klebol/Klebot_PCB/bom.xlsx

Sheet: Arkusz1
Nazwa | Obudowa | Ilość | URL | Stan
KONDENSATORY
1uF 6V | 0603 | 3 | https://www.tme.eu/pl/details/cl10b105ka8nnnc/kondensatory-mlcc-smd/samsung/ | X
10uF 10V | 0603 | 5 | https://www.tme.eu/pl/details/cl10a106mp8nnnc/kondensatory-mlcc-smd/samsung/ | X
22u 10V | 0805 | 3 | https://www.tme.eu/pl/details/0805x226m100ct/kondensatory-mlcc-smd/walsin/
100n 10V | 0603 | 18 | https://www.tme.eu/pl/details/cc0603krx7r8104/kondensatory-mlcc-smd/yageo/cc0603krx7r8bb104/ | X
4.7uF 6V | 0603 | 2 | https://www.tme.eu/pl/details/cl10a475ma8nqnc/kondensatory-mlcc-smd/samsung/ | X
2,7nF 6V | 0603 | 1 | https://www.tme.eu/pl/details/06035c272k4t2a/kondensatory-mlcc-smd/kyocera-avx/
47uF 10V | Ø6,3x5,8mm | 1 | https://www.tme.eu/pl/details/cd1e476m6l006vr/kondensatory-elektrolityczne-smd/samwha/ | M
2,2 uF 6V | 0603 | 1 | https://www.tme.eu/pl/details/cl10a225kp8nnnc/kondensatory-mlcc-smd/samsung/ | X
1,5 pF | 0402 | 1 | https://www.tme.eu/pl/details/grm1555c1h1r5ca01d/kondensatory-mlcc-smd/murata/
1pF | 0402 | 1 | https://www.tme.eu/pl/details/cc0402crnpo9bn1r0/kondensatory-mlcc-smd/yageo/
10pF | 0402 | 4 | https://www.tme.eu/pl/details/cc0402jrnpo9100/kondensatory-mlcc-smd/yageo/cc0402jrnpo9bn100/
2,2nF | 0402 | 2 | https://www.tme.eu/pl/details/0402b222k500ct/kondensatory-mlcc-smd/walsin/
4,7pF | 0402 | 1 | https://www.tme.eu/pl/details/cc0402crnpo9bn4r7/kondensatory-mlcc-smd/yageo/
33nF | 0603 | 1 | https://www.tme.eu/pl/details/0402b333k250ct/kondensatory-mlcc-smd/walsin/ | X
10nF | 0402 | 2 | https://www.tme.eu/pl/details/cc0603jrx7r9103/kondensatory-mlcc-smd/yageo/cc0603jrx7r9bb103/ | M1206
REZYSTORY
69k8 | 0603 | 1 | https://www.tme.eu/pl/details/era3aeb6982v/rezystory-smd/panasonic/
5k62 | 0603 | 1 | https://www.tme.eu/pl/details/erj3ekf5621v/rezystory-smd/panasonic/
330R | 0603 | 1 | https://www.tme.eu/pl/details/wf06p-330r-5%25/rezystory-smd/walsin/wf06p331jtl/ | X
1k | 0603 | 1 | https://www.tme.eu/pl/details/wf06p-1k-5%25/rezystory-smd/walsin/wf06p102jtl/ | X
18k | 0603 | 1 | https://www.tme.eu/pl/details/smd0603-18k-1%25/rezystory-smd/royal-ohm/0603saf1802t5e/
16k | 0603 | 1 | https://www.tme.eu/pl/details/wr06x163jtl/rezystory-smd/walsin/wr06x163-jtl/
1k87 | 0603 | 1 | https://www.tme.eu/pl/details/era3aeb1871v/rezystory-smd/panasonic/
100k | 0603 | 5 | https://www.tme.eu/pl/details/rc0603fr-07100k/rezystory-smd/yageo/rc0603fr-07100kl/ | X
1M | 0603 | 1 | https://www.tme.eu/pl/details/rc0603jr-071m/rezystory-smd/yageo/rc0603jr-071ml/ | M1206
22k | 0603 | 1 | https://www.tme.eu/pl/details/smd0603-22k-1%25/rezystory-smd/royal-ohm/0603saf2202t5e/ | X
10k | 0603 | 3 | https://www.tme.eu/pl/details/smd0603-10k-1%25/rezystory-smd/royal-ohm/0603saf1002t5e/ | X
2k2 | 0603 | 2 | https://www.tme.eu/pl/details/smd0603-2k2-1%25/rezystory-smd/royal-ohm/0603saf2201t5e/ | X
CEWKI
4u7 4,3A | 6,7x7,3x2,2 | 1 | https://www.tme.eu/pl/details/hpi0624-4r7/dlawiki-smd-mocy/ferrocore/ | X
4u7 650mA | 1210 | 1 | https://www.tme.eu/pl/details/lqh32cn4r7m53l/dlawiki-smd-1210/murata/ | X
3n9 | 0402 | 1 | https://www.tme.eu/pl/details/cl02st3n9-s/dlawiki-smd-0402/viking/
8n2 | 0402 | 1 | https://www.tme.eu/pl/details/cl02jt8n2-s/dlawiki-smd-0402/viking/
2n7 | 0402 | 1 | https://www.tme.eu/pl/details/cl02st2n7-s/dlawiki-smd-0402/viking/
100Mhz 120R | 0603 | 1 | https://www.tme.eu/pl/details/blm18ag121sh1d/ferryty-koraliki/murata/ | M
DIODY
LED ORANGE | 0603 | 1 |  | M0603
LED RED | 0603 | 1 | https://www.tme.eu/pl/details/fyls-0603urc/diody-led-smd-kolorowe/foryard/
LED BLUE | 0603 | 1 | https://www.tme.eu/pl/details/fyls-0603ubc/diody-led-smd-kolorowe/foryard/
40V 1A (Boost 5V) | SOD-123 | 2 | https://www.tme.eu/pl/details/1n5819hw-7-f/diody-schottky-smd/diodes-incorporated/
60V 4,2A (Boost 6V) | SOD-128 | 1 | https://www.tme.eu/pl/details/pmeg6030etpx/diody-schottky-smd/nexperia/
BAT54C-G3-08 | SOT-23 | 1 | https://www.tme.eu/pl/details/bat54c-g3-08/diody-schottky-smd/vishay/ | X
ZLĄCZA
HIROSE 5 PIN SOCKET |  | 1 | https://www.tme.eu/pl/details/df3a-5p-2dsa/zlacza-sygnalowe-raster-2-00mm/hirose/
HIROSE 4 PIN SOCKET |  | 3 | https://www.tme.eu/pl/details/df3a-4p-2dsa/zlacza-sygnalowe-raster-2-00mm/hirose/
HIROSE 5 PIN PLUG |  | 1 | https://www.tme.eu/pl/details/df3-5s-2c/zlacza-sygnalowe-raster-2-00mm/hirose/
HIROSE 4 PIN PLUG |  | 3 | https://www.tme.eu/pl/details/df3-4s-2c/zlacza-sygnalowe-raster-2-00mm/hirose/
2x5 IDC 2mm (SWD) PLUG |  | 1 |  | X
2x5 IDC 2mm (SWD) SOCKET |  | 1 | https://www.tme.eu/pl/details/zl303-2x10p/listwy-i-gniazda-kolkowe/connfly/ds1025-05-2-10p8bv1/ | X
2x5 IDC 2,54mm (QTR) PLUG |  | 1 | https://www.tme.eu/pl/details/ds1016-10masibb/zlacza-idc/connfly/ds1016-10ma2bb/
2x5 IDC 2,54mm (QTR) SOCKET |  | 1 | https://www.tme.eu/pl/details/zl231-10kg/zlacza-idc/connfly/ds1013-10rsib/ | X
MOTOR CONNECTOR SOCKET |  | 2 | https://www.tme.eu/pl/details/nx1500-06sms/zlacza-sygnalowe-raster-1-50mm/joint-tech/a1500wv-6p/
MOTOR CONNECTOR PLUG |  | 2 | https://www.tme.eu/pl/details/nx1501-06pfs/zlacza-sygnalowe-raster-1-50mm/joint-tech/a1500h-6p/
U.FL ANTENNA CONNECTOR |  | 1 |  | X
MICRO USB |  | 1
TRANZYSTORY
DMP2045U (SOFT POWERUP) | SOT-23 | 1 | https://www.tme.eu/pl/details/dmp2045u-7/tranzystory-z-kanalem-p-smd/diodes-incorporated/
BC847-QR (SOFT POWERUP) | SOT-23 | 1 | https://www.tme.eu/pl/details/bc847-qr/tranzystory-npn-smd/nexperia/
INNE
BUTTON | SMD | 3 | https://www.tme.eu/pl/details/tl3305cf160qg/mikroprzelaczniki-tact/e-switch/
USBLC6-2SC6 | SOT23-6 | 1 | https://www.tme.eu/pl/details/usblc6-2sc6/diody-zabezpieczajace-drabinki/stmicroelectronics/
MIC2288 |  | 1
LD1117S50 |  | 1 |  | X
LD1117S33 |  | 1 |  | X
MPU-6050 | QFN-24 | 1 |  | X
nRF34L01+ | QFN-20 | 1 |  | X
M24C02 | SOIC-8 | 1 |  | X
Crystal 16MHz | 3225 | 2 | https://www.tme.eu/pl/details/3225-16m-sr/rezonatory-kwarcowe-smd/sr-passives/
STM32F107RCTx |  | 1 |  | X
TPS61087 |  | 1
DRV8836 |  | 1

Sheet: Arkusz2
Nazwa | Obudowa | Ilość | URL | Stan
KONDENSATORY
1uF 6V | 0603 | 1 | https://www.tme.eu/pl/details/cl10b105ka8nnnc/kondensatory-mlcc-smd/samsung/ | X
10uF 10V | 0603 | 1 | https://www.tme.eu/pl/details/cl10a106mp8nnnc/kondensatory-mlcc-smd/samsung/ | X
22u 10V | 0805 | 1 | https://www.tme.eu/pl/details/0805x226m100ct/kondensatory-mlcc-smd/walsin/
100n 10V | 0603 | 13 | https://www.tme.eu/pl/details/cc0603krx7r8104/kondensatory-mlcc-smd/yageo/cc0603krx7r8bb104/ | X
4.7uF 6V | 0603 | 3 | https://www.tme.eu/pl/details/cl10a475ma8nqnc/kondensatory-mlcc-smd/samsung/ | X
2,2 uF 6V | 0603 | 1 | https://www.tme.eu/pl/details/cl10a225kp8nnnc/kondensatory-mlcc-smd/samsung/ | X
1,5 pF | 0402 | 1 | https://www.tme.eu/pl/details/grm1555c1h1r5ca01d/kondensatory-mlcc-smd/murata/
1pF | 0402 | 1 | https://www.tme.eu/pl/details/cc0402crnpo9bn1r0/kondensatory-mlcc-smd/yageo/
10pF | 0402 | 4 | https://www.tme.eu/pl/details/cc0402jrnpo9100/kondensatory-mlcc-smd/yageo/cc0402jrnpo9bn100/
2,2nF | 0402 | 2 | https://www.tme.eu/pl/details/0402b222k500ct/kondensatory-mlcc-smd/walsin/
4,7pF | 0402 | 1 | https://www.tme.eu/pl/details/cc0402crnpo9bn4r7/kondensatory-mlcc-smd/yageo/
33nF | 0402 | 1 | https://www.tme.eu/pl/details/0402b333k250ct/kondensatory-mlcc-smd/walsin/ | X
10nF | 0402 | 2 | https://www.tme.eu/pl/details/cc0603jrx7r9103/kondensatory-mlcc-smd/yageo/cc0603jrx7r9bb103/ | 1206M
REZYSTORY
5k62 | 0603 | 1 | https://www.tme.eu/pl/details/erj3ekf5621v/rezystory-smd/panasonic/
330R | 0603 | 1 | https://www.tme.eu/pl/details/wf06p-330r-5%25/rezystory-smd/walsin/wf06p331jtl/ | X
1k87 | 0603 | 1 | https://www.tme.eu/pl/details/era3aeb1871v/rezystory-smd/panasonic/
100k | 0603 | 2 | https://www.tme.eu/pl/details/rc0603fr-07100k/rezystory-smd/yageo/rc0603fr-07100kl/ | X
1M | 0603 | 1 | https://www.tme.eu/pl/details/rc0603jr-071m/rezystory-smd/yageo/rc0603jr-071ml/ | 1206M
22k | 0603 | 1 | https://www.tme.eu/pl/details/smd0603-22k-1%25/rezystory-smd/royal-ohm/0603saf2202t5e/ | X
10k | 0603 | 3 | https://www.tme.eu/pl/details/smd0603-10k-1%25/rezystory-smd/royal-ohm/0603saf1002t5e/ | X
2k2 | 0603 | 4 | https://www.tme.eu/pl/details/smd0603-2k2-1%25/rezystory-smd/royal-ohm/0603saf2201t5e/ | X
CEWKI
4u7 650mA | 1210 | 1 | https://www.tme.eu/pl/details/lqh32cn4r7m53l/dlawiki-smd-1210/murata/ | X
3n9 | 0402 | 1 | https://www.tme.eu/pl/details/cl02st3n9-s/dlawiki-smd-0402/viking/
8n2 | 0402 | 1 | https://www.tme.eu/pl/details/cl02jt8n2-s/dlawiki-smd-0402/viking/
2n7 | 0402 | 1 | https://www.tme.eu/pl/details/cl02st2n7-s/dlawiki-smd-0402/viking/
100Mhz 120R | 0603 | 1 | https://www.tme.eu/pl/details/blm18ag121sh1d/ferryty-koraliki/murata/ | M
DIODY
LED RED | 0603 | 1 | https://www.tme.eu/pl/details/fyls-0603urc/diody-led-smd-kolorowe/foryard/
LED BLUE | 0603 | 1 | https://www.tme.eu/pl/details/fyls-0603ubc/diody-led-smd-kolorowe/foryard/
40V 1A (Boost 5V) | SOD-123 | 2 | https://www.tme.eu/pl/details/1n5819hw-7-f/diody-schottky-smd/diodes-incorporated/
BAT54C-G3-08 | SOT-23 | 1 | https://www.tme.eu/pl/details/bat54c-g3-08/diody-schottky-smd/vishay/ | x
ZLĄCZA
HIROSE 4 PIN SOCKET |  | 1 | https://www.tme.eu/pl/details/df3a-4p-2dsa/zlacza-sygnalowe-raster-2-00mm/hirose/
SMA |  | 1
HIROSE 4 PIN PLUG |  | 1 | https://www.tme.eu/pl/details/df3-4s-2c/zlacza-sygnalowe-raster-2-00mm/hirose/
2x5 IDC 2mm (SWD) PLUG |  | 1
2x5 IDC 2mm (SWD) SOCKET |  | 1 | https://www.tme.eu/pl/details/zl303-2x10p/listwy-i-gniazda-kolkowe/connfly/ds1025-05-2-10p8bv1/
MICRO USB |  | 1
TRANZYSTORY
DMP2045U (SOFT POWERUP) | SOT-23 | 1 | https://www.tme.eu/pl/details/dmp2045u-7/tranzystory-z-kanalem-p-smd/diodes-incorporated/
BC847-QR (SOFT POWERUP) | SOT-23 | 1 | https://www.tme.eu/pl/details/bc847-qr/tranzystory-npn-smd/nexperia/
BXT520P02M | SOT-23 | 1 | https://www.tme.eu/pl/details/bxt520p02m/tranzystory-z-kanalem-p-smd/bridgelux/
INNE
BUTTON | SMD | 2 | https://www.tme.eu/pl/details/dtsm-66n-v-b/mikroprzelaczniki-tact/diptronics/
USBLC6-2SC6 | SOT23-6 | 1 | https://www.tme.eu/pl/details/usblc6-2sc6/diody-zabezpieczajace-drabinki/stmicroelectronics/
MIC2288 |  | 1
ENCODER |  | 2 | https://www.tme.eu/pl/details/ec11e20-20p20c-sw/enkodery-inkrementalne/sr-passives/
LD1117S33 |  | 1 |  | X
MPU-6050 | QFN-24 | 1 |  | X
nRF34L01+ | QFN-20 | 1 |  | X
M24C02 | SOIC-8 | 1 |  | X
Crystal 16MHz | 3225 | 2 | https://www.tme.eu/pl/details/3225-16m-sr/rezonatory-kwarcowe-smd/sr-passives/
STM32F411RCTx |  | 1 |  | X
JOYSTICK |  | 2 |  | X
