klebol/Klebot_PCB/Drv_board.kicad_pcb

## KiCad design Drv_board.kicad_pcb (2023-10-12)

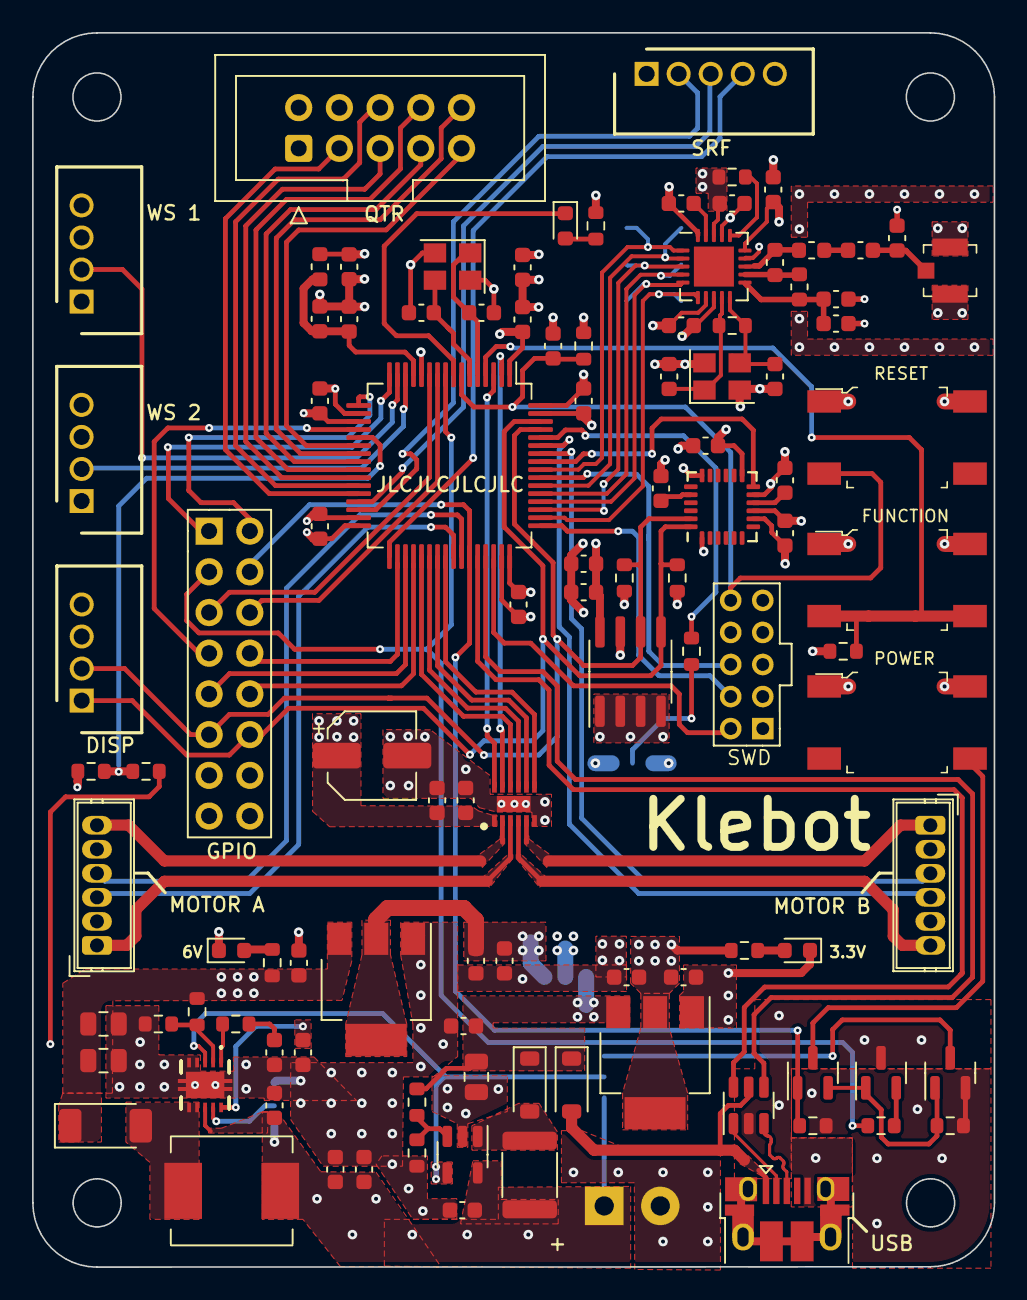
[picture p1: board Drv_board.kicad_pcb from above]

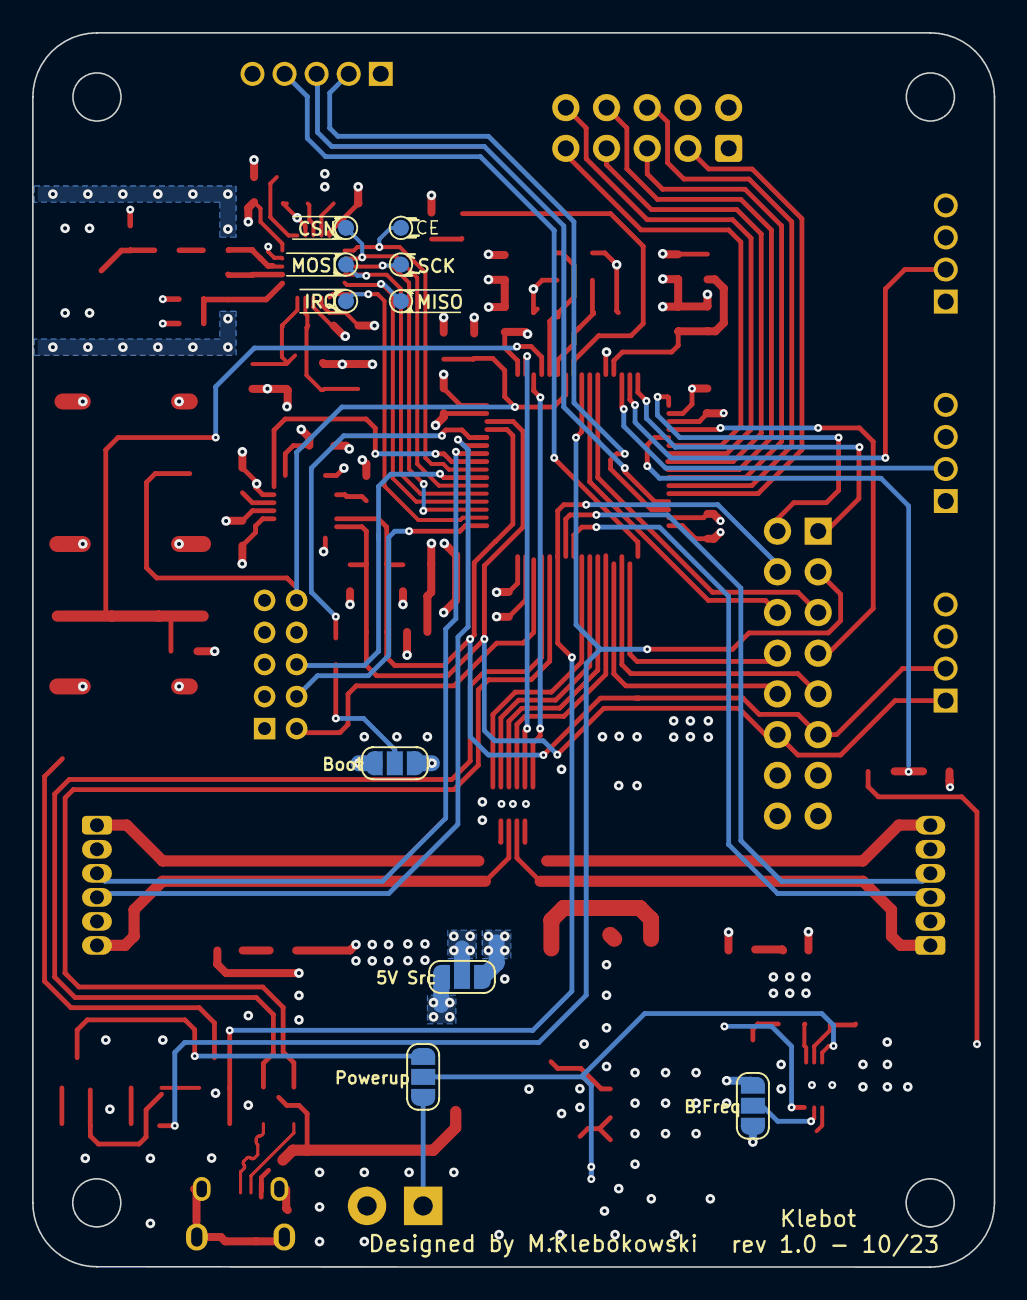
[picture p2: board Drv_board.kicad_pcb from below]

Board: 4 copper layers, 60.0 x 77.0 mm, 118 parts (10 on the bottom side), 96 nets.

Parts:
BT1: Battery; TerminalBlock_Phoenix_PT-1,5-2-3.5-H_1x02_P3.50mm_Horizontal
C1: 4u7; C_0603_1608Metric
C2, C3, C4, C5, C6, C10, C18, C20, C23, C25, C27, C30, C33, C34, C35, C42, C43, C45: 100n; C_0603_1608Metric
C7, C41: 10n; C_0603_1608Metric
C8, C9, C13: 1u; C_0603_1608Metric
C11, C12, C36, C37: 10p; C_0603_1608Metric
C14, C15, C19, C26, C29: 10u; C_0603_1608Metric
C16, C17: 22u; C_0805_2012Metric
C21: 4u7 6.3V; C_0603_1608Metric
C22: 22uF 6.3V; C_0805_2012Metric
C24: 2n7; C_0603_1608Metric
C28: 47u; CP_Elec_5x5.9
C31: 1p5; C_0603_1608Metric
C32: 1p; C_0603_1608Metric
C38, C46: 2n2; C_0603_1608Metric
C39: 4p7; C_0603_1608Metric
C40: 33n; C_0603_1608Metric
C44: 2u2; C_0603_1608Metric
D1: LED BLUE; LED_0603_1608Metric
D2: BAT54C; SOT-23
D3, D5: 40V 1A; D_SOD-123
D4: PMEG6030ETPX; D_SOD-128
D6: LED RED; LED_0603_1608Metric
D7: LED ORANGE; LED_0603_1608Metric
FB1: 120R; L_0603_1608Metric
IC1: TPS61087DRCR
IC2: DRV8836DSSR; SON50P200X300X80-13N-D
J1: USB_B_Micro; USB_Micro-B_Amphenol_10103594-0001LF_Horizontal
J2: WS_LED_1_CONN; SHDR4W55P0X200_1X4_1000X500X530P
J3: WS_LED_0_CONN; SHDR4W55P0X200_1X4_1000X500X530P
J4: QTR_CONN; IDC-Header_2x05_P2.54mm_Vertical
J5: SRF-05_CONN; SHDR5W55P0X200_1X5_1200X500X530P
J6: OLED_CONN; SHDR4W55P0X200_1X4_1000X500X530P
J7: SWD; PinHeader_2x05_P2.00mm_Vertical
J8: Motor A; Wuerth_WR-WTB_64800611622_1x06_P1.50mm_Vertical
J9: Motor B; Wuerth_WR-WTB_64800611622_1x06_P1.50mm_Vertical
J10: U.FL; Coax_Conn_U.FL
J11: BREAKOUT; PinHeader_2x08_P2.54mm_Vertical
JP1: 5V Source; SolderJumper-3_P1.3mm_Open_RoundedPad1.0x1.5mm
JP2: Powerup Mode; SolderJumper-3_P1.3mm_Open_RoundedPad1.0x1.5mm
JP3: Boost Converter Freqency; SolderJumper-3_P1.3mm_Open_RoundedPad1.0x1.5mm
L1: 4u7; L_Neosid_SM-PIC0602H
L2: 4.7uH 650mA; L_1812_4532Metric
L3: 3n9; L_0603_1608Metric
L4: 8n2; L_0603_1608Metric
L5: 2n7; L_0603_1608Metric
Q1: DMP2045U; SOT-23
Q2: BC847-QR; SOT-23
R1, R2, R4: 10k; R_0603_1608Metric
R3: ?; R_0603_1608Metric
R5, R6, R7, R8, R9: 100k; R_0603_1608Metric
R10: 69k8; R_0603_1608Metric
R11: 5k62; R_0603_1608Metric
R12: 330R; R_0603_1608Metric
R13: 1k; R_0603_1608Metric
R14: 18k; R_0603_1608Metric
R15: 16k; R_0603_1608Metric
R16: 1k87; R_0603_1608Metric
R17: 1M; R_0603_1608Metric
R18: 22k; R_0603_1608Metric
R19, R20: 2k2; R_0603_1608Metric
S1: RESET; Switch_Tactile_SMD_6x6mm
S2: USER_BUTTON; Switch_Tactile_SMD_6x6mm
S3: POWER UP; Switch_Tactile_SMD_6x6mm
SW1: SW_BOOT; SolderJumper-3_P1.3mm_Open_RoundedPad1.0x1.5mm
TP1: Test MOSI; TestPoint_Pad_D1.0mm
TP2: Test MISO; TestPoint_Pad_D1.0mm
TP3: Test SCK; TestPoint_Pad_D1.0mm
TP4: Test CSN; TestPoint_Pad_D1.0mm
TP5: Test CE; TestPoint_Pad_D1.0mm
TP6: Test IRQ; TestPoint_Pad_D1.0mm
U1: USBLC6-2SC6; SOT-23-6
U2: STM32F107RCTx; LQFP-64_10x10mm_P0.5mm
U3: LD1117S33; SOT-223-3_TabPin2
U4: MIC2288; TSOT-23-5
U5: LD1117S50; SOT-223-3_TabPin2
U6: nRF24L01P; QFN-20-1EP_4x4mm_P0.5mm_EP2.5x2.5mm
U7: M24C02-FMN; SOIC-8_3.9x4.9mm_P1.27mm
U8: MPU-6050; InvenSense_QFN-24_4x4mm_P0.5mm
Y1, Y2: 16 MHz; Crystal_SMD_3225-4Pin_3.2x2.5mm

Connections:
5V_Conv: C18.1, C22.1, D3.1 (K), D5.1 (K), JP1.3 (B), R11.1, U3.3 (VI)
5V_Stab: C26.1, C27.1, JP1.1 (A), U5.2 (VO)
+3.3V: C1.1, C2.1, C3.1, C4.1, C5.1, C6.1, C9.1, C19.1, C20.1, C33.1, C34.1, C35.1, C41.2, C42.2, C43.1, C44.1, FB1.2, J4.1, J6.3, J7.1, J8.5, J9.5, J11.14, R2.1, R3.2, R4.1, R12.1, R18.1, R19.1, R20.1, SW1.1 (A), U2.1 (VBAT), U2.19 (VDD), U2.32 (VDD), U2.48 (VDD), U2.64 (VDD), U3.2 (VO), U6.7 (VDD), U6.15 (VDD), U6.18 (VDD), U7.8 (VCC), U8.8 (VLOGIC), U8.13 (VDD)
+3.3VA: C7.1, C8.1, FB1.1, U2.13 (VDDA)
+5V: J2.3, J3.3, J5.1, J11.16, JP1.2 (C)
+6V: C16.1, C17.1, C25.1, C28.1, C29.1, C30.1, D4.1 (K), IC2.1 (VCC), R10.1, R13.1, U5.3 (VI)
+BATT: BT1.1 (+), C13.1, C14.1, C15.1, C21.1, IC1.8 (IN), JP2.1 (A), JP3.3 (B), L1.1, L2.1, Q1.2 (S), R5.1, R6.1, R7.2, U4.5 (VIN)
A1: IC2.2 (AOUT1), J8.6
A2: IC2.3 (AOUT2), J8.1
B1: IC2.4 (BOUT1), J9.6
B2: IC2.5 (BOUT2), J9.1
BATT_ADC_0: R7.1, R9.2, U2.21 (PA5)
BOOT0: R1.1, U2.60 (BOOT0)
DRV_AIN1/APHASE: IC2.10 (AIN1/APHASE), U2.37 (PC6)
DRV_AIN2/AENBL: IC2.9 (AIN2/AENBL), U2.38 (PC7)
DRV_BIN1/BPHASE: IC2.8 (BIN1_/_BPHASE), U2.39 (PC8)
DRV_BIN2/BENBL: IC2.7 (BIN2/BENBL), U2.40 (PC9)
DRV_MODE: IC2.11 (MODE), U2.2 (PC13)
DRV_NSLEEP: IC2.12 (NSLEEP), U2.3 (PC14)
EN: IC1.3 (EN), JP2.2 (C), U4.4 (EN)
ENC_A_1: J8.3, U2.41 (PA8)
ENC_A_2: J8.4, U2.42 (PA9)
ENC_B_1: J9.3, U2.58 (PB6)
ENC_B_2: J9.4, U2.59 (PB7)
EXT_PA4: J11.7, U2.20 (PA4)
EXT_PC2: J11.6, U2.10 (PC2)
EXT_PC3: J11.5, U2.11 (PC3)
EXT_SPI_MISO: J11.9, U2.35 (PB14)
EXT_SPI_MOSI: J11.10, U2.36 (PB15)
EXT_SPI_SCK: J11.8, U2.34 (PB13)
EXT_USART_RX: J11.2, U2.17 (PA3)
EXT_USART_TX: J11.1, U2.16 (PA2)
GND: BT1.2 (-), C1.2, C2.2, C3.2, C4.2, C5.2, C6.2, C7.2, C8.2, C9.2, C10.2, C11.2, C12.2, C13.2, C14.2, C15.2, C16.2, C17.2, C18.2, C19.2, C20.2, C21.2, C22.2, C23.2, C24.2, C25.2, C26.2, C27.2, C28.2, C29.2, C30.2, C32.2, C33.2, C34.2, C35.2, C36.2, C37.2, C38.1, C39.1, C40.2, C41.1, C42.1, C43.2, C44.2, C45.1, C46.1, D6.1 (K), D7.1 (K), IC1.4 (AGND_1), IC1.5 (PGND), IC1.11 (AGND_2), IC1.12 (AGND_3), IC1.13 (AGND_4), IC1.14 (AGND_5), IC1.15 (AGND_6), IC2.6 (GND_1), IC2.13 (GND_2), J1.5 (GND), J2.1, J2.4, J3.1, J3.4, J4.2, J5.5, J6.4, J7.3, J7.5, J7.9, J8.2, J9.2, J10.1, J11.13, J11.15, JP3.1 (A), Q2.3 (E), R9.1, R14.2, R16.2, S1.1, S1.2, S2.1, S2.2, S3.1, S3.2, SW1.3 (C), U1.2 (GND), U2.12 (VSSA), U2.18 (VSS), U2.31 (VSS), U2.47 (VSS), U2.63 (VSS), U3.1 (GND), U4.2 (GND), U5.1 (GND), U6.8 (VSS), U6.14 (VSS), U6.17 (VSS), U6.20 (VSS), U7.1 (E0), U7.2 (E1), U7.3 (E2), U7.4 (VSS), U7.7 (~WC), U8.1 (CLKIN), U8.9 (AD0), U8.11 (FSYNC), U8.18 (GND), Y1.2, Y1.4, Y2.2, Y2.4
I2C_SCL: J6.2, J11.11, R19.2, U2.61 (PB8), U7.6 (SCL), U8.23 (SCL)
I2C_SDA: J6.1, J11.12, R20.2, U2.62 (PB9), U7.5 (SDA), U8.24 (SDA)
KEEP_ALIVE: J11.3, R8.2, U2.9 (PC1)
LATCH_POWERUP: JP2.3 (B), Q1.3 (D)
MPU-6050_IRQ: U2.57 (PB5), U8.12 (INT)
NRF_ANT1: L4.2, L5.1, U6.12 (ANT1)
NRF_ANT2: L3.1, L4.1, U6.13 (ANT2)
NRF_CE: TP5.1, U2.56 (PB4), U6.1 (CE)
NRF_CSN: TP4.1, U2.54 (PD2), U6.2 (CSN)
NRF_IRQ: TP6.1, U2.50 (PA15), U6.6 (IRQ)
NRF_MISO: TP2.1, U2.52 (PC11), U6.5 (MISO)
NRF_MOSI: TP1.1, U2.53 (PC12), U6.4 (MOSI)
NRF_SCK: TP3.1, U2.51 (PC10), U6.3 (SCK)
NRF_VDD_PA: C38.2, C39.2, L5.2, U6.11 (VDD_PA)
NRF_XC1: C37.1, R17.2, U6.10 (XC1), Y2.3
NRF_XC2: C36.1, R17.1, U6.9 (XC2), Y2.1
NRST: C10.1, J7.10, R2.2, S1.3, U2.7 (NRST)
unnamed: C24.1, R15.2
unnamed: C31.1, L3.2
unnamed: C31.2, C32.1, J10.2
unnamed: D1.2 (A), R3.1
unnamed: D1.1 (K), U2.8 (PC0)
unnamed: D2.3, S3.4
unnamed: D4.2 (A), IC1.6 (SW_1), IC1.7 (SW_2), L1.2
unnamed: D5.2 (A), L2.2, U4.1 (SW)
unnamed: D6.2 (A), R12.2
unnamed: D7.2 (A), R13.2
unnamed: IC1.1 (COMP), R15.1
unnamed: IC1.2 (FB), R10.2, R14.1
unnamed: IC1.9 (FREQ), JP3.2 (C)
unnamed: C23.1, IC1.10 (SS)
unnamed: D2.2, Q1.1 (G), Q2.1 (C), R6.2
unnamed: Q2.2 (B), R8.1
unnamed: R1.2, SW1.2 (B)
unnamed: R4.2, S2.3, S2.4, U2.4 (PC15)
unnamed: C11.1, U2.5 (PD0), Y1.1
unnamed: C12.1, U2.6 (PD1), Y1.3
unnamed: R11.2, R16.1, U4.3 (FB)
unnamed: C40.1, U6.19 (DVDD)
unnamed: R18.2, U6.16 (IREF)
unnamed: C46.2, U8.20 (CPOUT)
unnamed: C45.2, U8.10 (REGOUT)
Power_Btn: D2.1, J11.4, R5.2, U2.43 (PA10)
QTR_0: J4.9, U2.22 (PA6)
QTR_1: J4.10, U2.23 (PA7)
QTR_2: J4.7, U2.24 (PC4)
QTR_3: J4.8, U2.25 (PC5)
QTR_4: J4.5, U2.26 (PB0)
QTR_5: J4.6, U2.27 (PB1)
QTR_CTRL: J4.3, U2.28 (PB2)
SRF-05_ECHO: J5.3, U2.29 (PB10)
SRF-05_IN: J5.4, U2.33 (PB12)
SRF-05_TRIG: J5.2, U2.30 (PB11)
SWCLK: J7.4, U2.49 (PA14)
SWDIO: J7.2, U2.46 (PA13)
SWO: J7.6, U2.55 (PB3)
USB_CONN_D+: J1.3 (D+), U1.3 (I/O2)
USB_CONN_D-: J1.2 (D-), U1.1 (I/O1)
USB_D+: U1.4 (I/O2), U2.45 (PA12)
USB_D-: U1.6 (I/O1), U2.44 (PA11)
V_USB: D3.2 (A), J1.1 (VBUS), U1.5 (VBUS)
WS_LED_0: J3.2, U2.15 (PA1)
WS_LED_1: J2.2, U2.14 (PA0)
