klebol/Klebot_PCB/(commit log)

2023-09-06 fixed footprint placement
    [Drv_board.kicad_sch]
2023-09-06 working on power
    [Drv_board.kicad_sch]
2023-09-08 Added power supply and motor schematics
    [Drv_board.kicad_sch, Power_supply.kicad_sch, motors.kicad_sch]
2023-09-11 work progress
    [Drv_board.kicad_sch, motors.kicad_sch, peripherals.kicad_sch]
2023-09-12 most of the components added
    [Drv_board.kicad_sch, motors.kicad_sch, peripherals.kicad_sch]
2023-09-13 schematic completed
    [Drv_board.kicad_pcb, Drv_board.kicad_sch, Power_supply.kicad_sch, motors.kicad_sch, peripherals.kicad_sch]
2023-09-18 done boost converter layout
    [Drv_board.kicad_pcb, Drv_board.kicad_sch, Power_supply.kicad_sch, bom.xlsx]
2023-09-29 working on pcb
    [Drv_board.kicad_pcb, Drv_board.kicad_sch, Power_supply.kicad_sch, bom.xlsx, motors.kicad_sch, peripherals.kicad_sch]
2023-09-29 more layout added
    [Drv_board.kicad_pcb, Drv_board.kicad_sch, Power_supply.kicad_sch, motors.kicad_sch]
2023-10-01 layout in progress
    [Drv_board.kicad_pcb, peripherals.kicad_sch]
2023-10-02 more layout
    [Drv_board.kicad_pcb, Drv_board.kicad_sch]
2023-10-05 layout finalising
    [Drv_board.kicad_pcb, Drv_board.kicad_sch, Power_supply.kicad_sch]
2023-10-09 layout completed
    [Drv_board-B_Cu.gbr, Drv_board-B_Mask.gbr, Drv_board-B_Paste.gbr, Drv_board-B_Silkscreen.gbr, Drv_board-Edge_Cuts.gbr, Drv_board-F_Cu.gbr, Drv_board-F_Mask.gbr, Drv_board-F_Paste.gbr]
2023-10-12 Completed PCB v1.0
    [Drv_board-B_Cu.gbl, Drv_board-B_Mask.gbs, Drv_board-B_Paste.gbp, Drv_board-B_Silkscreen.gbo, Drv_board-Edge_Cuts.gm1, Drv_board-F_Cu.gtl, Drv_board-F_Mask.gts, Drv_board-F_Paste.gtp]
